microcris/kicad_library/README.md

# kicad_library
Personal Kicad library
test
