microcris/kicad_library/(commit log)

2017-10-06 New devices added
2017-10-16 new devices
2018-06-27 Please enter the commit message for your changes. Lines starting with '#' will be ignored, and an empty message aborts the commit.
    Committer: Cristiano Rodrigues <cris@HP-CRIS.SINEPOWER.LAN>
    On branch master
    Your branch is up to date with 'origin/master'.
    Changes to be committed:
    new file: .directory
    new file: my_library.3dshapes/CP_Elec_18x16.8.STEP
    new file: my_library.3dshapes/SRP1238A.STP
    modified: my_library.bck
    modified: my_library.dcm
    modified: my_library.lib
    new file: my_library.pretty/CP_Elec_18x16.8.kicad_mod
    new file: my_library.pretty/L_Bourns-SRP1238A.kicad_mod
    new file: plugins/KiBoM-master/.gitignore
    new file: plugins/KiBoM-master/.travis.y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
2018-12-07 Changes to be committed: new file: my_library.3dshapes/.directory new file: my_library.3dshapes/ARJE-0034.STEP new file: my_library.3dshapes/MTC1.step new file: my_library.3dshapes/SLD09S13A4F.stp ne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
